onionsat-pcbs/gaia-camera/cansat-camera-pcb/3dmodels/F33Z-1A7Q1-E8C24.stp

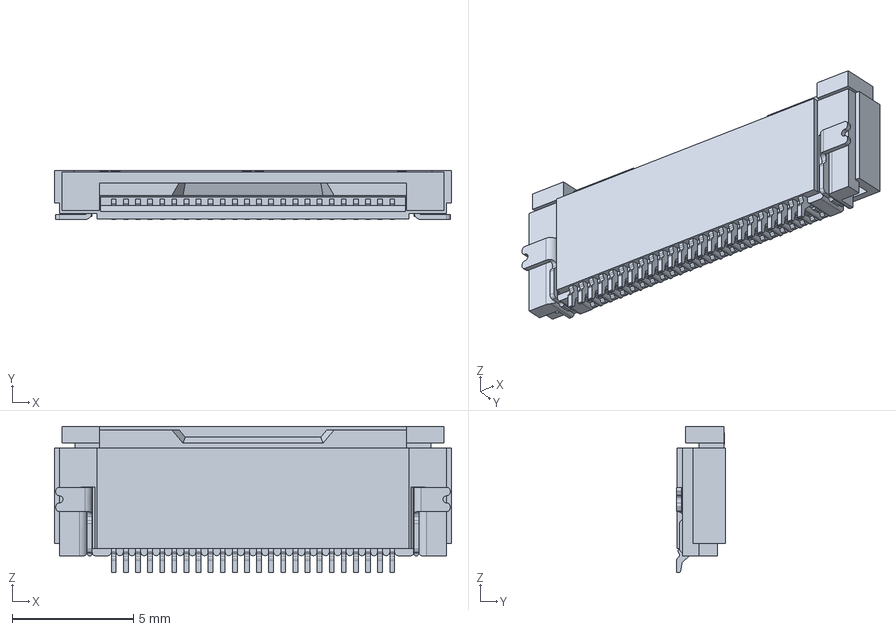
[picture p1: CAD file, 2026-01-25]
cansat-camera-pcb/3dmodels/F33Z-1A7Q1-E8C24.stp
16.4 x 2.03 x 6.05 mm
