onionsat-pcbs/gaia-camera/cansat-camera-pcb/3dmodels/HDR-SMD_8P-P2.00-H-F-W9.2.step

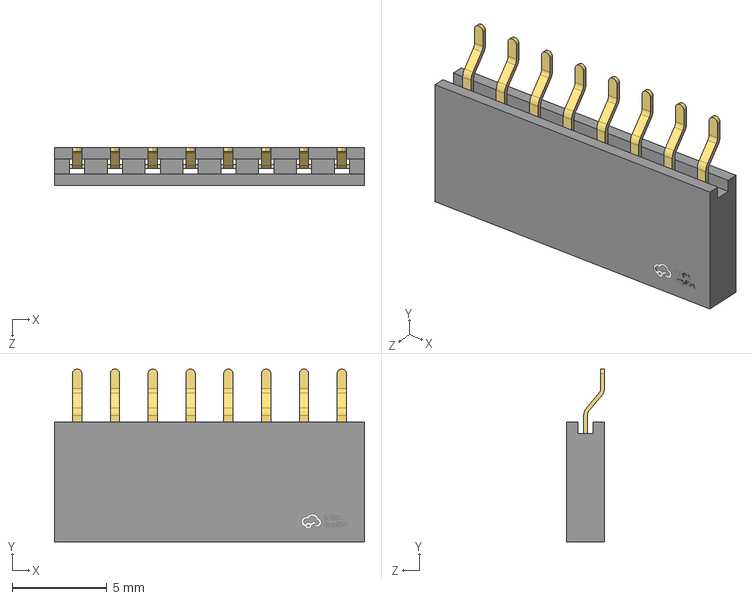
[picture p2: CAD file, 2026-01-25]
cansat-camera-pcb/3dmodels/HDR-SMD_8P-P2.00-H-F-W9.2.step
16.4 x 9.15 x 2.01 mm
