onionsat-pcbs/gaia-camera/cansat-camera-pcb/3dmodels/HDR2.00-F-LS-2X10P.step

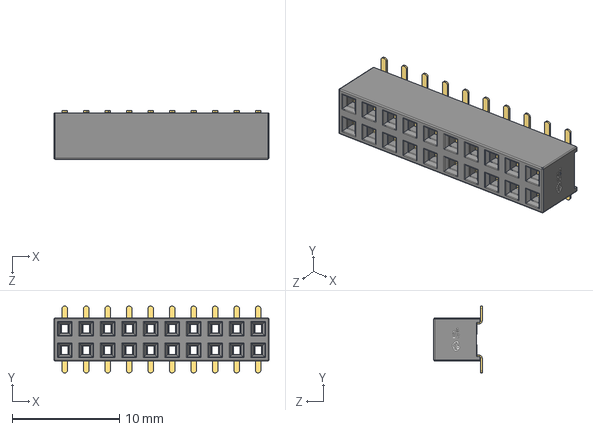
[picture p3: CAD file, 2026-01-07]
cansat-camera-pcb/3dmodels/HDR2.00-F-LS-2X10P.step
20.0 x 6.20 x 4.52 mm
