onionsat-pcbs/gaia-camera/cansat-camera-pcb/3dmodels/OV5640.step

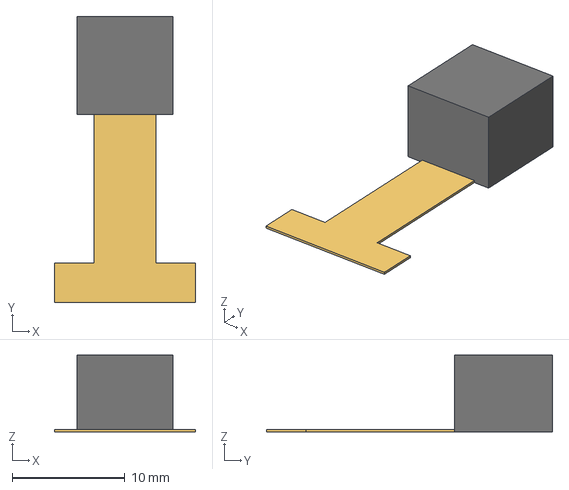
[picture p4: CAD file, 2026-01-03]
cansat-camera-pcb/3dmodels/OV5640.step
12.5 x 25.4 x 6.81 mm
