onionsat-pcbs/gaia-camera/cansat-camera-pcb/3dmodels/KEY-SMD_L4.0-W3.0-LS4.9.step

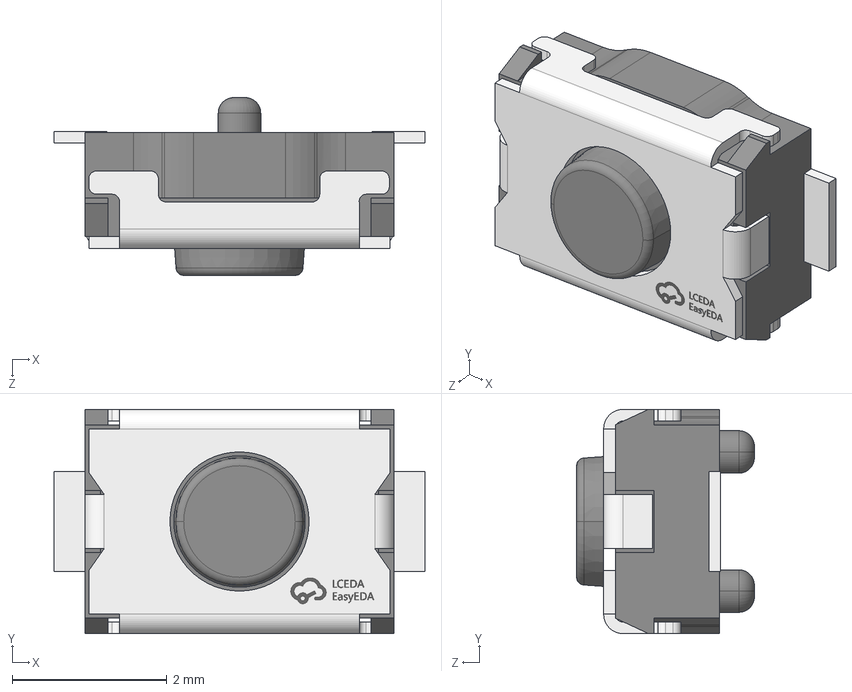
[picture p5: CAD file, 2026-01-03]
cansat-camera-pcb/3dmodels/KEY-SMD_L4.0-W3.0-LS4.9.step
4.80 x 2.90 x 2.30 mm
