onionsat-pcbs/gaia-camera/cansat-camera-pcb/cansat-camera-pcb.kicad_pcb

## KiCad design cansat-camera-pcb/cansat-camera-pcb.kicad_pcb (2026-03-02)

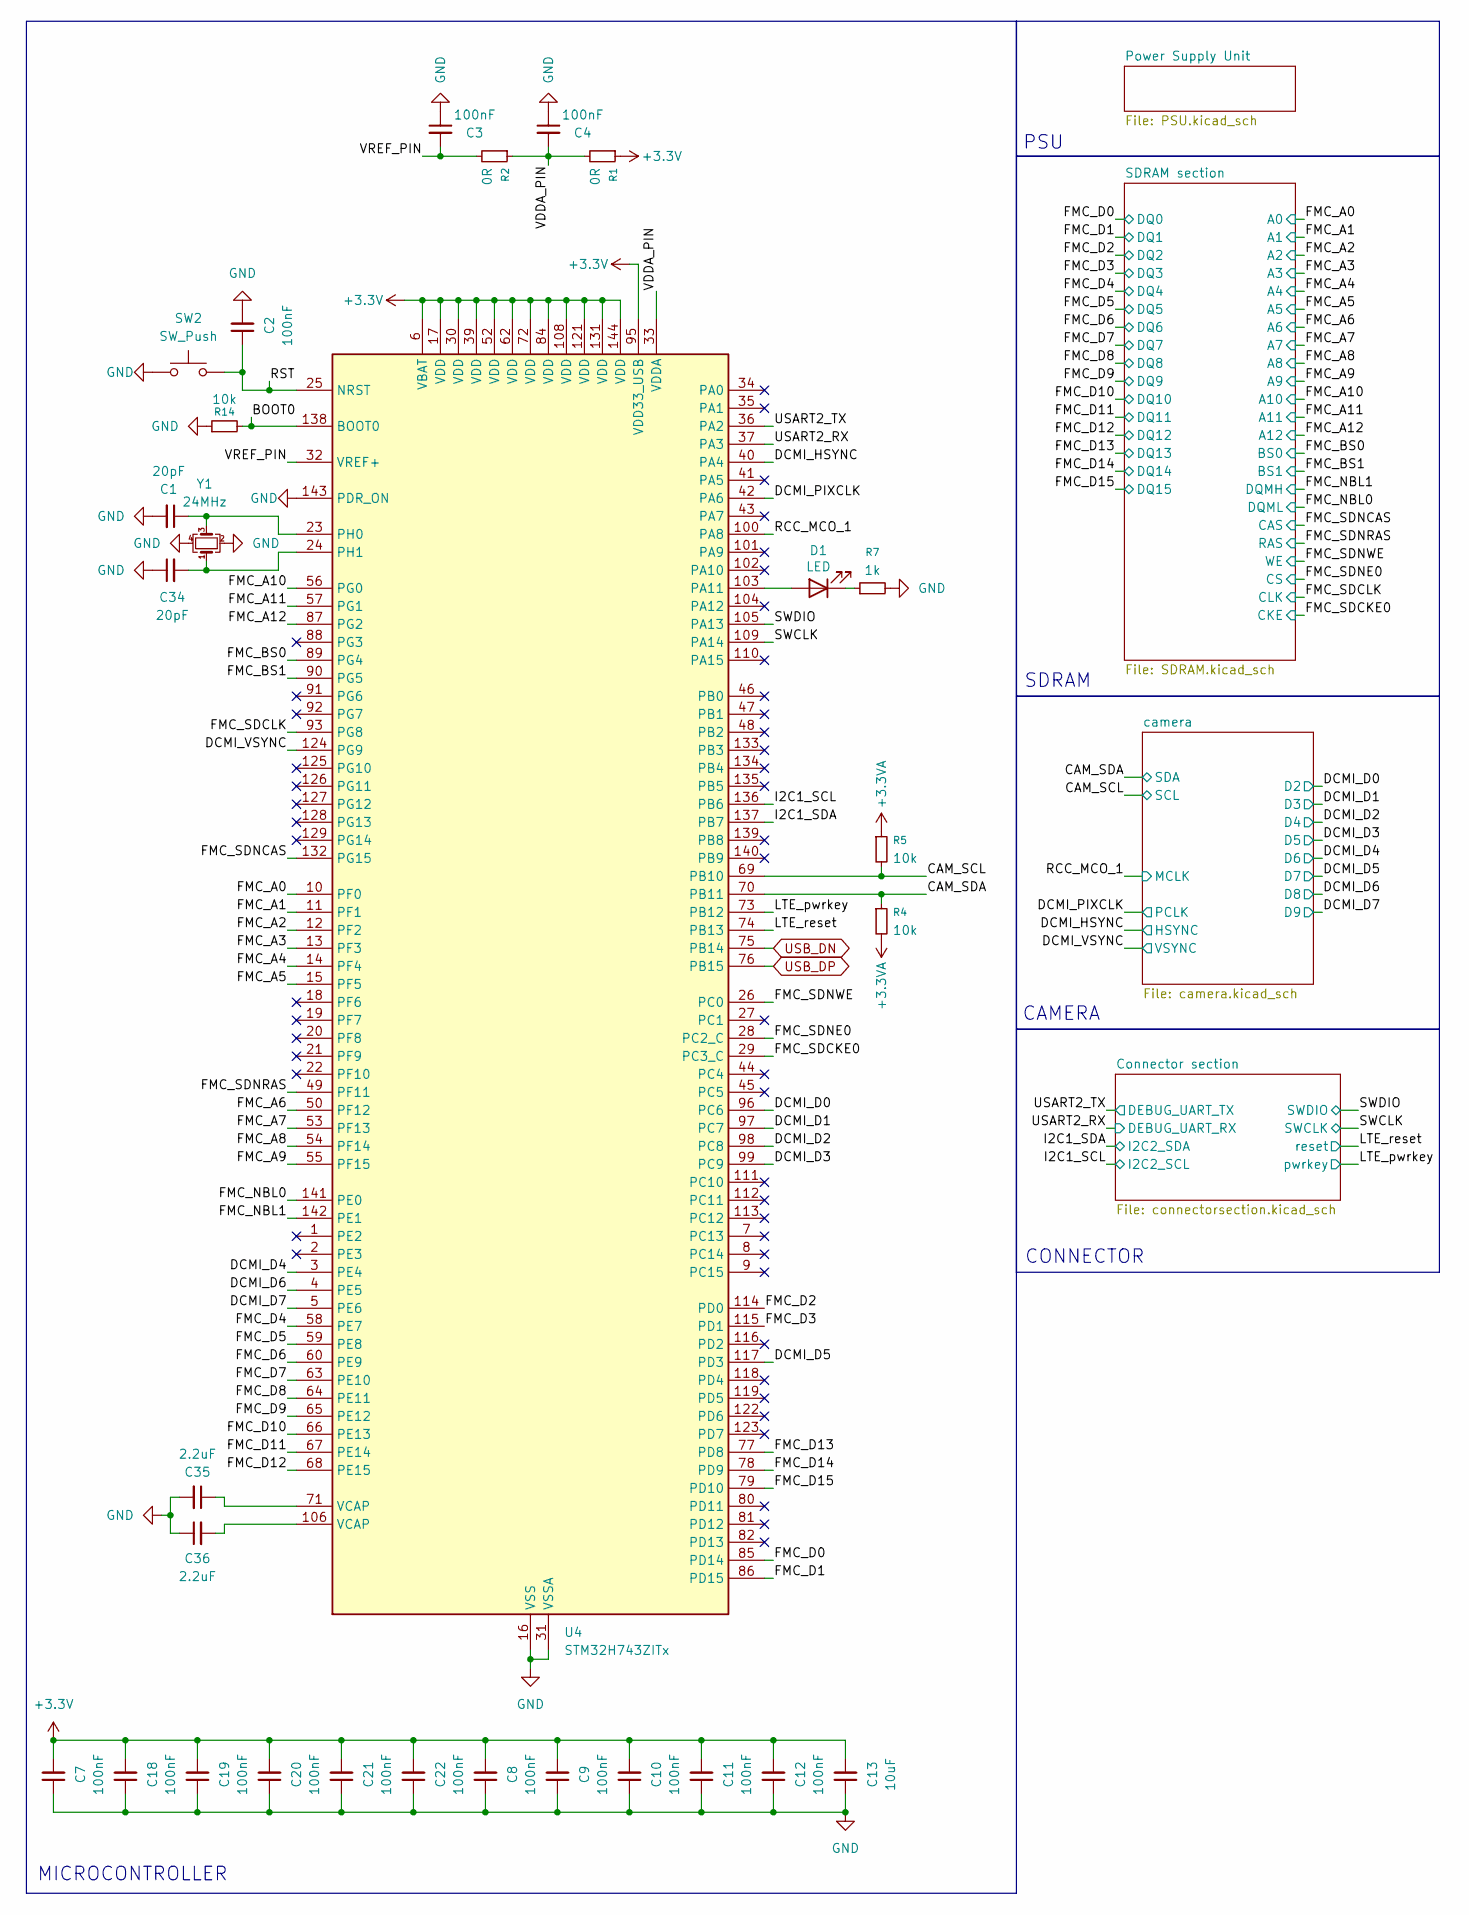
[picture p6: schematic cansat-camera-pcb.kicad_sch, CS26 Camera modul root]

Parts:
C1, C34: 20pF; C_0402_1005Metric
C2, C3, C4, C7, C8, C9, C10, C11, C12, C18, C19, C20, C21, C22: 100nF; C_0402_1005Metric
C13: 10uF; C_0603_1608Metric
C35, C36: 2.2uF; C_0603_1608Metric
D1: LED; LED_0603_1608Metric
R1, R2: 0R; R_0402_1005Metric
R4, R5, R14: 10k; R_0402_1005Metric
R7: 1k; R_0603_1608Metric
SW2: SW_Push; KEY-SMD_L4.0-W3.0-LS4.9-1
U4: STM32H743ZITx; LQFP-144_20x20mm_P0.5mm
Y1: 24MHz; Crystal_SMD_3225-4Pin_3.2x2.5mm

Connections:
+3.3V: C7.2, C8.2, C9.2, C10.2, C11.2, C12.2, C13.2, C18.2, C19.2, C20.2, C21.2, C22.2, R1.1, U4.6 (VBAT), U4.17 (VDD), U4.30 (VDD), U4.39 (VDD), U4.52 (VDD), U4.62 (VDD), U4.72 (VDD), U4.84 (VDD), U4.95 (VDD33_USB), U4.108 (VDD), U4.121 (VDD), U4.131 (VDD), U4.144 (VDD); also elsewhere on the board
+3.3VA: R4.2, R5.1; also elsewhere on the board
/BOOT0: R14.2, U4.138 (BOOT0)
/CAM_SCL: R5.2, U4.69 (PB10); also elsewhere on the board
/CAM_SDA: R4.1, U4.70 (PB11); also elsewhere on the board
/DCMI_D0: U4.96 (PC6); also elsewhere on the board
/DCMI_D1: U4.97 (PC7); also elsewhere on the board
/DCMI_D2: U4.98 (PC8); also elsewhere on the board
/DCMI_D3: U4.99 (PC9); also elsewhere on the board
/DCMI_D4: U4.3 (PE4); also elsewhere on the board
/DCMI_D5: U4.117 (PD3); also elsewhere on the board
/DCMI_D6: U4.4 (PE5); also elsewhere on the board
/DCMI_D7: U4.5 (PE6); also elsewhere on the board
/DCMI_HSYNC: U4.40 (PA4); also elsewhere on the board
/DCMI_PIXCLK: U4.42 (PA6); also elsewhere on the board
/DCMI_VSYNC: U4.124 (PG9); also elsewhere on the board
/FMC_A0: U4.10 (PF0); also elsewhere on the board
/FMC_A1: U4.11 (PF1); also elsewhere on the board
/FMC_A2: U4.12 (PF2); also elsewhere on the board
/FMC_A3: U4.13 (PF3); also elsewhere on the board
/FMC_A4: U4.14 (PF4); also elsewhere on the board
/FMC_A5: U4.15 (PF5); also elsewhere on the board
/FMC_A6: U4.50 (PF12); also elsewhere on the board
/FMC_A7: U4.53 (PF13); also elsewhere on the board
/FMC_A8: U4.54 (PF14); also elsewhere on the board
/FMC_A9: U4.55 (PF15); also elsewhere on the board
/FMC_A10: U4.56 (PG0); also elsewhere on the board
/FMC_A11: U4.57 (PG1); also elsewhere on the board
/FMC_A12: U4.87 (PG2); also elsewhere on the board
/FMC_BS0: U4.89 (PG4); also elsewhere on the board
/FMC_BS1: U4.90 (PG5); also elsewhere on the board
/FMC_D0: U4.85 (PD14); also elsewhere on the board
/FMC_D1: U4.86 (PD15); also elsewhere on the board
/FMC_D2: U4.114 (PD0); also elsewhere on the board
/FMC_D3: U4.115 (PD1); also elsewhere on the board
/FMC_D4: U4.58 (PE7); also elsewhere on the board
/FMC_D5: U4.59 (PE8); also elsewhere on the board
/FMC_D6: U4.60 (PE9); also elsewhere on the board
/FMC_D7: U4.63 (PE10); also elsewhere on the board
/FMC_D8: U4.64 (PE11); also elsewhere on the board
/FMC_D9: U4.65 (PE12); also elsewhere on the board
/FMC_D10: U4.66 (PE13); also elsewhere on the board
/FMC_D11: U4.67 (PE14); also elsewhere on the board
/FMC_D12: U4.68 (PE15); also elsewhere on the board
/FMC_D13: U4.77 (PD8); also elsewhere on the board
/FMC_D14: U4.78 (PD9); also elsewhere on the board
/FMC_D15: U4.79 (PD10); also elsewhere on the board
/FMC_NBL0: U4.141 (PE0); also elsewhere on the board
/FMC_NBL1: U4.142 (PE1); also elsewhere on the board
/FMC_SDCKE0: U4.29 (PC3_C); also elsewhere on the board
/FMC_SDCLK: U4.93 (PG8); also elsewhere on the board
/FMC_SDNCAS: U4.132 (PG15); also elsewhere on the board
/FMC_SDNE0: U4.28 (PC2_C); also elsewhere on the board
/FMC_SDNRAS: U4.49 (PF11); also elsewhere on the board
/FMC_SDNWE: U4.26 (PC0); also elsewhere on the board
/I2C1_SCL: U4.136 (PB6); also elsewhere on the board
/I2C1_SDA: U4.137 (PB7); also elsewhere on the board
/LTE_pwrkey: U4.73 (PB12); also elsewhere on the board
/LTE_reset: U4.74 (PB13); also elsewhere on the board
/RCC_MCO_1: U4.100 (PA8); also elsewhere on the board
/RST: C2.1, SW2.2, U4.25 (NRST)
/SWCLK: U4.109 (PA14); also elsewhere on the board
/SWDIO: U4.105 (PA13); also elsewhere on the board
/USART2_RX: U4.37 (PA3); also elsewhere on the board
/USART2_TX: U4.36 (PA2); also elsewhere on the board
/VDDA_PIN: C4.2, R1.2, R2.1, U4.33 (VDDA)
/VREF_PIN: C3.2, R2.2, U4.32 (VREF+)
GND: C1.2, C2.2, C3.1, C4.1, C7.1, C8.1, C9.1, C10.1, C11.1, C12.1, C13.1, C18.1, C19.1, C20.1, C21.1, C22.1, C34.1, C35.2, C36.1, R7.2, R14.1, SW2.1, U4.16 (VSS), U4.31 (VSSA), U4.38 (VSS), U4.51 (VSS), U4.61 (VSS), U4.83 (VSS), U4.94 (VSS), U4.107 (VSS), U4.120 (VSS), U4.130 (VSS), U4.143 (PDR_ON), Y1.2, Y1.4; also elsewhere on the board
unnamed: C35.1, U4.71 (VCAP)
unnamed: C36.2, U4.106 (VCAP)
unnamed: D1.2 (A), U4.103 (PA11)
unnamed: D1.1 (K), R7.1
unnamed: C1.1, U4.23 (PH0), Y1.3
unnamed: C34.2, U4.24 (PH1), Y1.1
USB_DN: U4.75 (PB14); also elsewhere on the board
USB_DP: U4.76 (PB15); also elsewhere on the board

Notes on the sheet:
PSU
SDRAM
MICROCONTROLLER
CAMERA
CONNECTOR

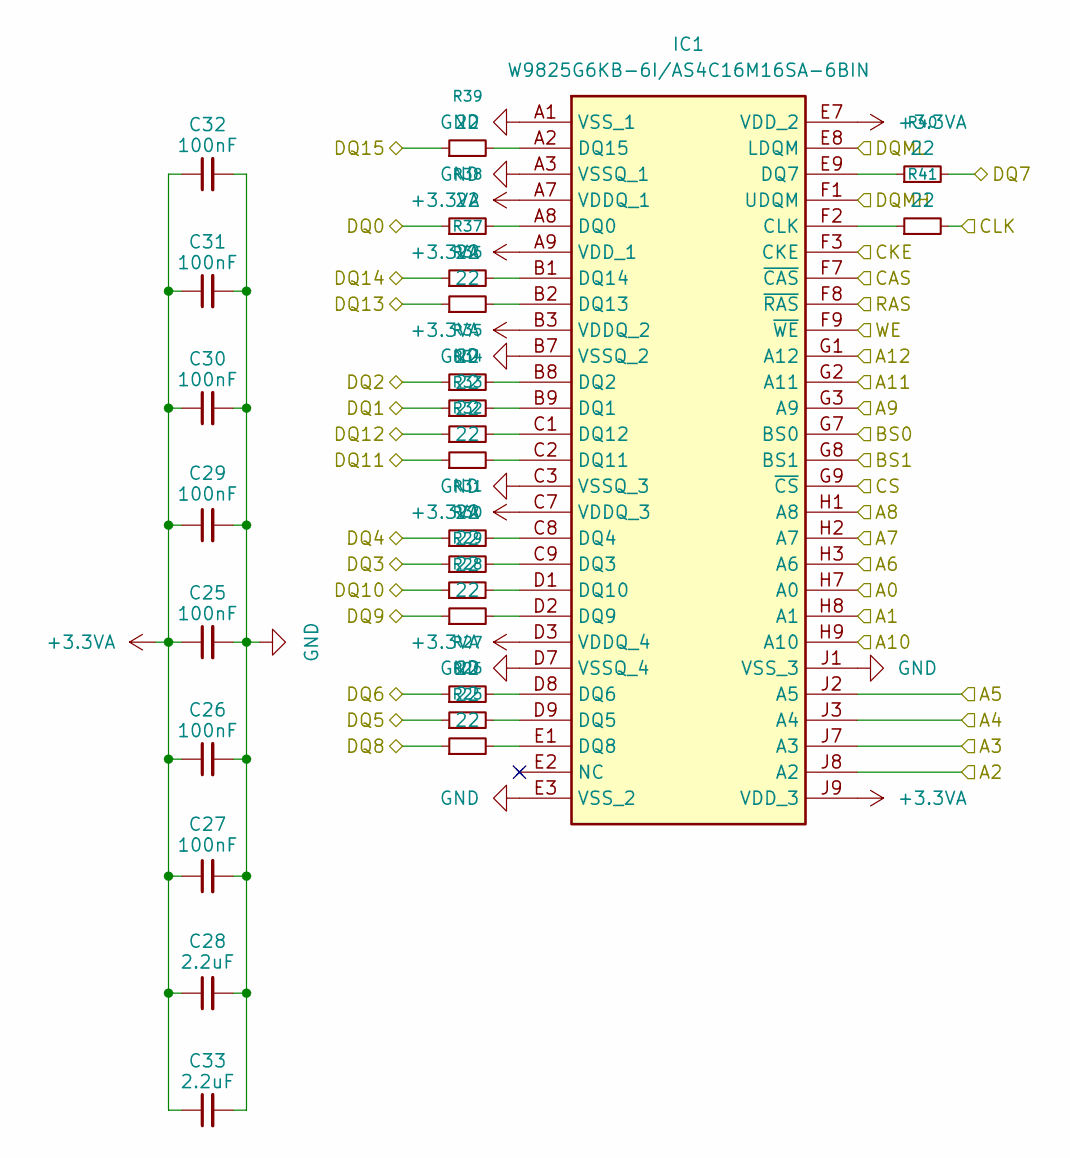
[picture p7: schematic SDRAM.kicad_sch, CS26 Camera modul SDRAM section]

Parts:
C25, C26, C27, C29, C30, C31, C32: 100nF; C_0402_1005Metric
C28, C33: 2.2uF; C_0603_1608Metric
IC1: W9825G6KB-6I/AS4C16M16SA-6BIN; Alliance_TFBGA-54_8x8mm_Layout9x9_P0.8mm; Mouser Part Number 454-W9825G6JB-6I
R25, R26, R27, R28, R29, R30, R31, R32, R33, R34, R35, R36, R37, R38, R39, R40, R41: 22; R_0201_0603Metric

Connections:
+3.3VA: C25.1, C26.1, C27.1, C28.1, C29.1, C30.1, C31.1, C32.1, C33.1, IC1.A7 (VDDQ_1), IC1.A9 (VDD_1), IC1.B3 (VDDQ_2), IC1.C7 (VDDQ_3), IC1.D3 (VDDQ_4), IC1.E7 (VDD_2), IC1.J9 (VDD_3); also elsewhere on the board
/FMC_A0: IC1.H7 (A0); also elsewhere on the board
/FMC_A1: IC1.H8 (A1); also elsewhere on the board
/FMC_A2: IC1.J8 (A2); also elsewhere on the board
/FMC_A3: IC1.J7 (A3); also elsewhere on the board
/FMC_A4: IC1.J3 (A4); also elsewhere on the board
/FMC_A5: IC1.J2 (A5); also elsewhere on the board
/FMC_A6: IC1.H3 (A6); also elsewhere on the board
/FMC_A7: IC1.H2 (A7); also elsewhere on the board
/FMC_A8: IC1.H1 (A8); also elsewhere on the board
/FMC_A9: IC1.G3 (A9); also elsewhere on the board
/FMC_A10: IC1.H9 (A10); also elsewhere on the board
/FMC_A11: IC1.G2 (A11); also elsewhere on the board
/FMC_A12: IC1.G1 (A12); also elsewhere on the board
/FMC_BS0: IC1.G7 (BS0); also elsewhere on the board
/FMC_BS1: IC1.G8 (BS1); also elsewhere on the board
/FMC_D0: R38.1; also elsewhere on the board
/FMC_D1: R34.1; also elsewhere on the board
/FMC_D2: R35.1; also elsewhere on the board
/FMC_D3: R30.1; also elsewhere on the board
/FMC_D4: R31.1; also elsewhere on the board
/FMC_D5: R26.1; also elsewhere on the board
/FMC_D6: R27.1; also elsewhere on the board
/FMC_D7: R40.2; also elsewhere on the board
/FMC_D8: R25.1; also elsewhere on the board
/FMC_D9: R28.1; also elsewhere on the board
/FMC_D10: R29.1; also elsewhere on the board
/FMC_D11: R32.1; also elsewhere on the board
/FMC_D12: R33.1; also elsewhere on the board
/FMC_D13: R36.1; also elsewhere on the board
/FMC_D14: R37.1; also elsewhere on the board
/FMC_D15: R39.1; also elsewhere on the board
/FMC_NBL0: IC1.E8 (LDQM); also elsewhere on the board
/FMC_NBL1: IC1.F1 (UDQM); also elsewhere on the board
/FMC_SDCKE0: IC1.F3 (CKE); also elsewhere on the board
/FMC_SDCLK: R41.2; also elsewhere on the board
/FMC_SDNCAS: IC1.F7 (~CAS); also elsewhere on the board
/FMC_SDNE0: IC1.G9 (~CS); also elsewhere on the board
/FMC_SDNRAS: IC1.F8 (~RAS); also elsewhere on the board
/FMC_SDNWE: IC1.F9 (~WE); also elsewhere on the board
GND: C25.2, C26.2, C27.2, C28.2, C29.2, C30.2, C31.2, C32.2, C33.2, IC1.A1 (VSS_1), IC1.A3 (VSSQ_1), IC1.B7 (VSSQ_2), IC1.C3 (VSSQ_3), IC1.D7 (VSSQ_4), IC1.E3 (VSS_2), IC1.J1 (VSS_3); also elsewhere on the board
unnamed: IC1.F2 (CLK), R41.1
unnamed: IC1.A8 (DQ0), R38.2
unnamed: IC1.B9 (DQ1), R34.2
unnamed: IC1.B8 (DQ2), R35.2
unnamed: IC1.C9 (DQ3), R30.2
unnamed: IC1.C8 (DQ4), R31.2
unnamed: IC1.D9 (DQ5), R26.2
unnamed: IC1.D8 (DQ6), R27.2
unnamed: IC1.E9 (DQ7), R40.1
unnamed: IC1.E1 (DQ8), R25.2
unnamed: IC1.D2 (DQ9), R28.2
unnamed: IC1.D1 (DQ10), R29.2
unnamed: IC1.C2 (DQ11), R32.2
unnamed: IC1.C1 (DQ12), R33.2
unnamed: IC1.B2 (DQ13), R36.2
unnamed: IC1.B1 (DQ14), R37.2
unnamed: IC1.A2 (DQ15), R39.2

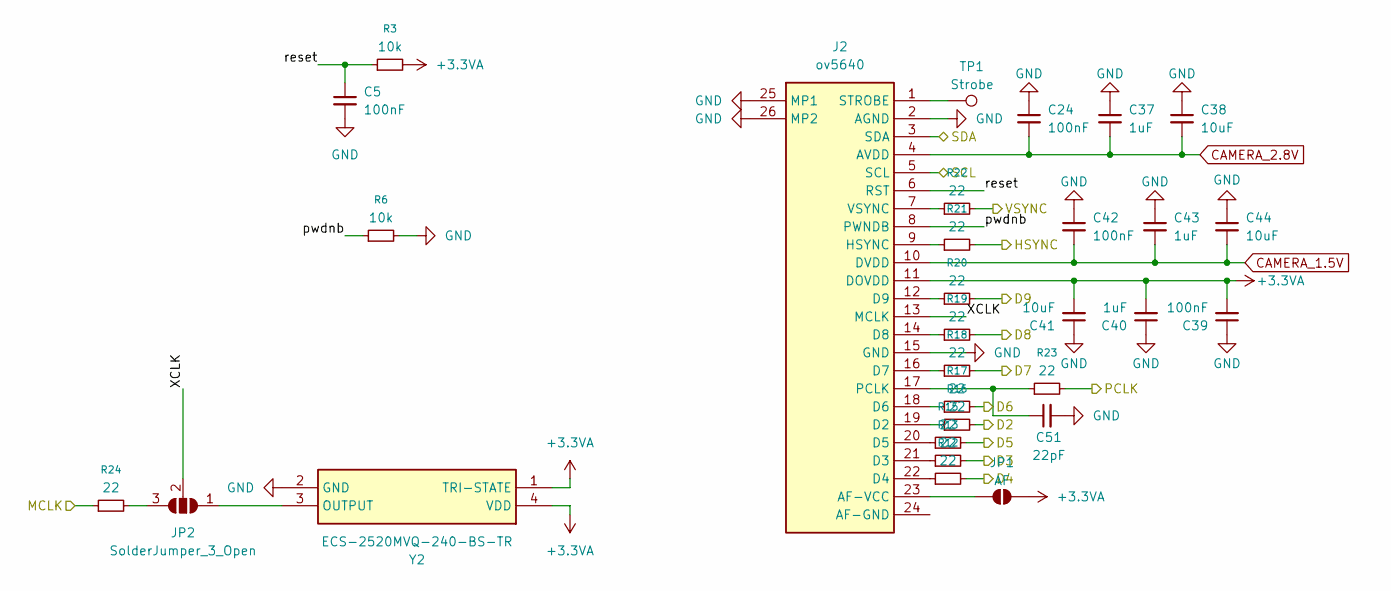
[picture p8: schematic camera.kicad_sch, CS26 Camera modul camera section]

Parts:
C5, C24, C39, C42: 100nF; C_0402_1005Metric
C37, C40, C43: 1uF; C_0603_1608Metric
C38, C41, C44: 10uF; C_0603_1608Metric
C51: 22pF; C_0402_1005Metric
J2: ov5640; F33Z1A7Q1E8C24; Manufacturer_Part_Number F33Z-1A7Q1-E8C24
JP1: AF; SolderJumper-2_P1.3mm_Open_Pad1.0x1.5mm
JP2: SolderJumper_3_Open; SolderJumper-3_P1.3mm_Open_Pad1.0x1.5mm
R3, R6: 10k; R_0402_1005Metric
R12, R13, R15, R16, R17, R18, R19, R20, R21, R22, R23, R24: 22; R_0201_0603Metric
TP1: Strobe; TestPoint_Pad_1.5x1.5mm
Y2: ECS-2520MVQ-240-BS-TR; ECS2520MVQ240BSTR; Mouser Part Number 520-E2520MVQ240BSTR

Connections:
+3.3VA: C39.2, C40.2, C41.2, J2.11 (DOVDD), JP1.2 (B), R3.2, Y2.1 (TRI-STATE), Y2.4 (VDD); also elsewhere on the board
/CAM_SCL: J2.5 (SCL); also elsewhere on the board
/CAM_SDA: J2.3 (SDA); also elsewhere on the board
/DCMI_D0: R16.2; also elsewhere on the board
/DCMI_D1: R13.2; also elsewhere on the board
/DCMI_D2: R12.2; also elsewhere on the board
/DCMI_D3: R15.2; also elsewhere on the board
/DCMI_D4: R17.2; also elsewhere on the board
/DCMI_D5: R18.2; also elsewhere on the board
/DCMI_D6: R19.2; also elsewhere on the board
/DCMI_D7: R20.2; also elsewhere on the board
/DCMI_HSYNC: R21.2; also elsewhere on the board
/DCMI_PIXCLK: R23.2; also elsewhere on the board
/DCMI_VSYNC: R22.2; also elsewhere on the board
/RCC_MCO_1: R24.1; also elsewhere on the board
/camera/XCLK: J2.13 (MCLK), JP2.2 (C)
/camera/pwdnb: J2.8 (PWNDB), R6.1
/camera/reset: C5.1, J2.6 (RST), R3.1
CAMERA_1.5V: C42.2, C43.2, C44.2, J2.10 (DVDD); also elsewhere on the board
CAMERA_2.8V: C24.2, C37.2, C38.2, J2.4 (AVDD); also elsewhere on the board
GND: C5.2, C24.1, C37.1, C38.1, C39.1, C40.1, C41.1, C42.1, C43.1, C44.1, C51.2, J2.2 (AGND), J2.15 (GND), J2.25 (MP1), J2.26 (MP2), R6.2, Y2.2 (GND); also elsewhere on the board
unnamed: J2.23 (AF-VCC), JP1.1 (A)
unnamed: J2.19 (D2), R16.1
unnamed: J2.21 (D3), R13.1
unnamed: J2.22 (D4), R12.1
unnamed: J2.20 (D5), R15.1
unnamed: J2.18 (D6), R17.1
unnamed: J2.16 (D7), R18.1
unnamed: J2.14 (D8), R19.1
unnamed: J2.12 (D9), R20.1
unnamed: J2.9 (HSYNC), R21.1
unnamed: C51.1, J2.17 (PCLK), R23.1
unnamed: J2.1 (STROBE), TP1.1
unnamed: J2.7 (VSYNC), R22.1
unnamed: JP2.1 (A), Y2.3 (OUTPUT)
unnamed: JP2.3 (B), R24.2

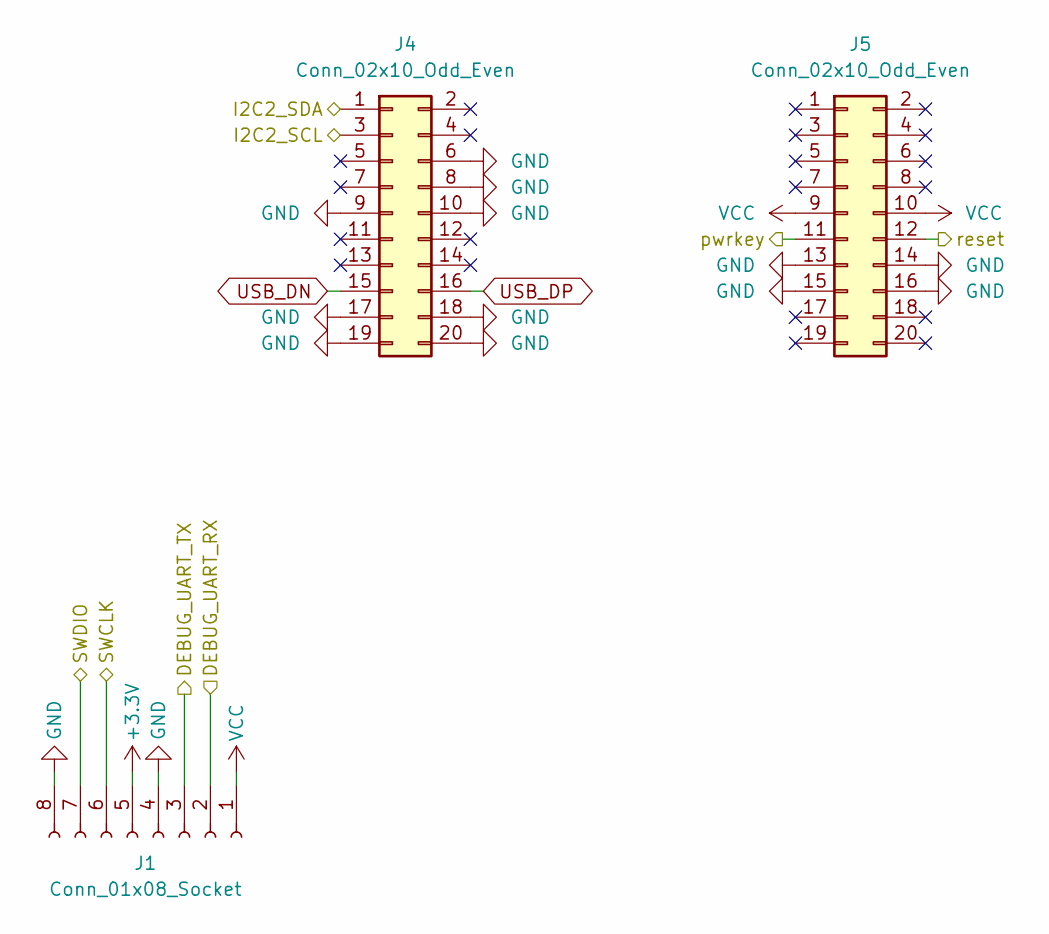
[picture p9: schematic connectorsection.kicad_sch, OnionSAT]

Parts:
J1: Conn_01x08_Socket; HDR-SMD_8P-P2.00-H-F-W9.2
J4, J5: Conn_02x10_Odd_Even; PinHeader_2x10_P2.00mm_Vertical_SMD

Connections:
+3.3V: J1.5; also elsewhere on the board
/I2C1_SCL: J4.3; also elsewhere on the board
/I2C1_SDA: J4.1; also elsewhere on the board
/LTE_pwrkey: J5.11; also elsewhere on the board
/LTE_reset: J5.12; also elsewhere on the board
/SWCLK: J1.6; also elsewhere on the board
/SWDIO: J1.7; also elsewhere on the board
/USART2_RX: J1.2; also elsewhere on the board
/USART2_TX: J1.3; also elsewhere on the board
GND: J1.4, J1.8, J4.6, J4.8, J4.9, J4.10, J4.17, J4.18, J4.19, J4.20, J5.13, J5.14, J5.15, J5.16; also elsewhere on the board
USB_DN: J4.15; also elsewhere on the board
USB_DP: J4.16; also elsewhere on the board
VCC: J1.1, J5.9, J5.10; also elsewhere on the board

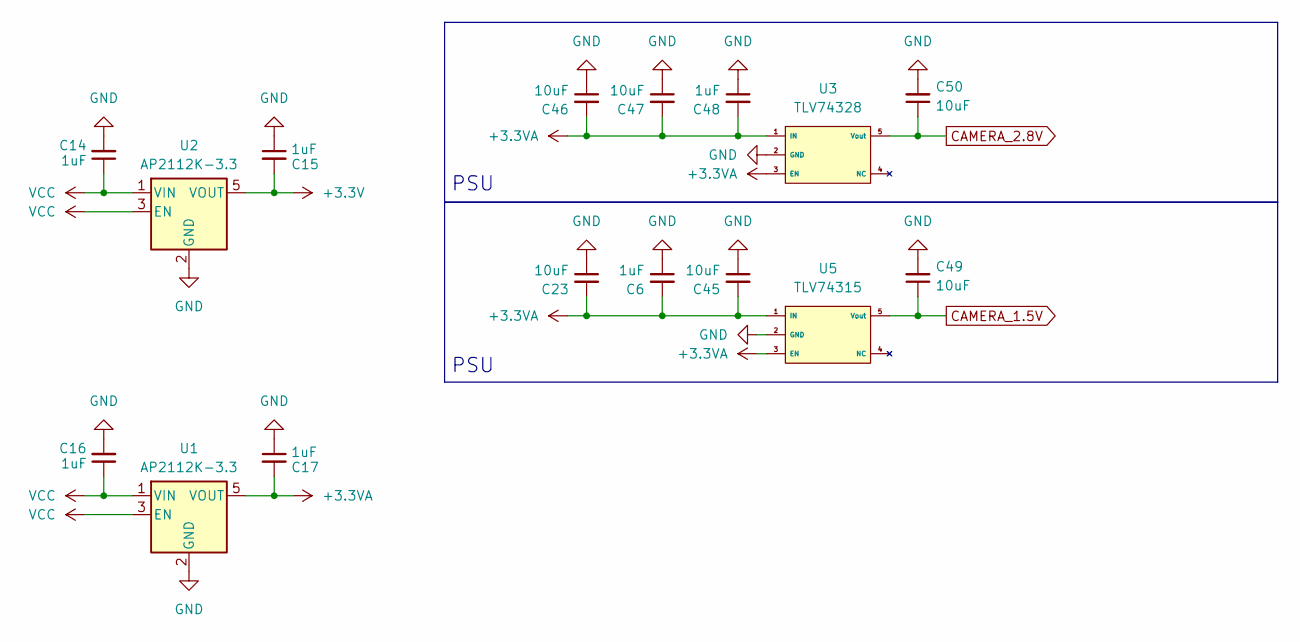
[picture p10: schematic PSU.kicad_sch, CS26 Camera modul PSU section]

Parts:
C6, C14, C15, C16, C17, C48: 1uF; C_0603_1608Metric
C23, C45, C46, C47, C49, C50: 10uF; C_0603_1608Metric
U1, U2: AP2112K-3.3; SOT-23-5
U3: TLV74328; SOT-23-5
U5: TLV74315; SOT-23-5

Connections:
+3.3V: C15.2, U2.5 (VOUT); also elsewhere on the board
+3.3VA: C6.2, C17.2, C23.2, C45.2, C46.2, C47.2, C48.2, U1.5 (VOUT), U3.1 (IN), U3.3 (EN), U5.1 (IN), U5.3 (EN); also elsewhere on the board
CAMERA_1.5V: C49.1, U5.5 (Vout); also elsewhere on the board
CAMERA_2.8V: C50.1, U3.5 (Vout); also elsewhere on the board
GND: C6.1, C14.2, C15.1, C16.2, C17.1, C23.1, C45.1, C46.1, C47.1, C48.1, C49.2, C50.2, U1.2 (GND), U2.2 (GND), U3.2 (GND), U5.2 (GND); also elsewhere on the board
VCC: C14.1, C16.1, U1.1 (VIN), U1.3 (EN), U2.1 (VIN), U2.3 (EN); also elsewhere on the board

Notes on the sheet:
PSU

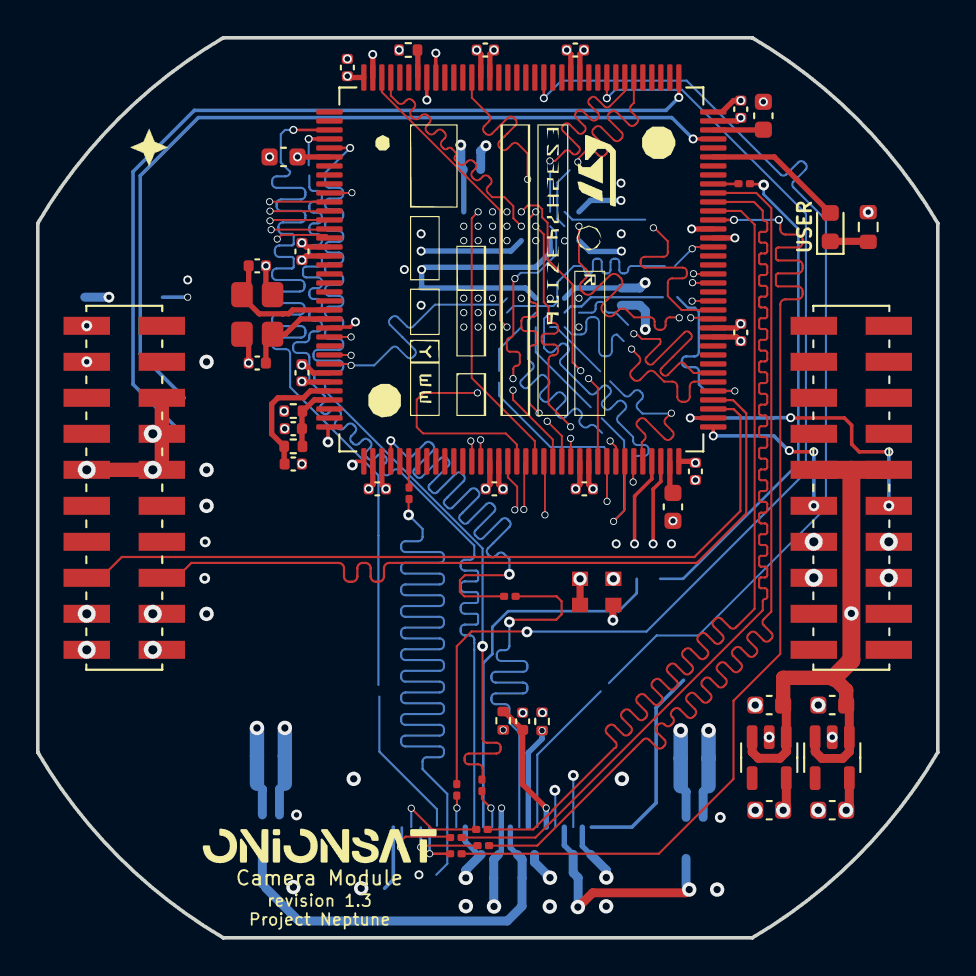
[picture p11: board cansat-camera-pcb.kicad_pcb from above]

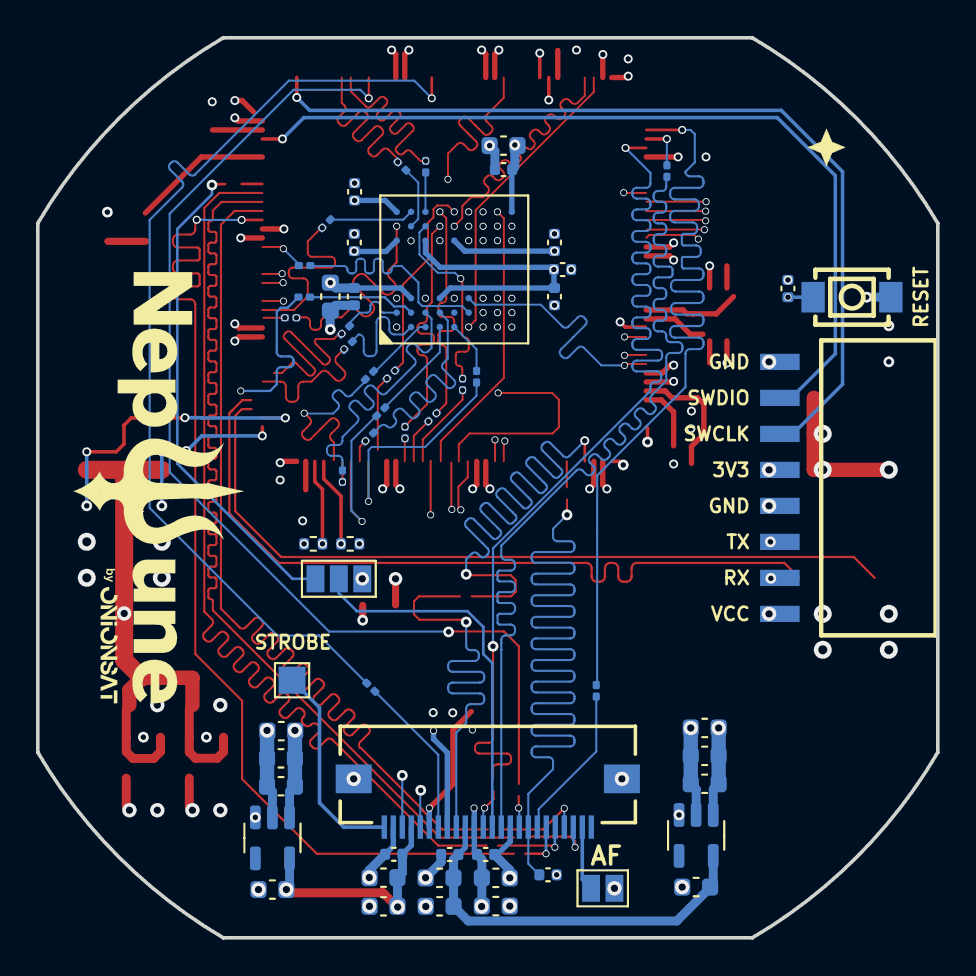
[picture p12: board cansat-camera-pcb.kicad_pcb from below]

Board: 8 copper layers, 50.0 x 50.0 mm, 105 parts (59 on the bottom side), 114 nets.
