onionsat-pcbs/gaia-camera/cansat-camera-pcb/cansat-camera-pcb.ioc

Mcu.UserName=STM32H743ZITx
PA11.Signal=GPIO_Output
PA2.Signal=USART2_TX
PA3.Signal=USART2_RX
PA4.Signal=DCMI_HSYNC
PA6.Signal=DCMI_PIXCLK
PA8.Signal=RCC_MCO_1
PB10.Signal=I2C2_SCL
PB11.Signal=I2C2_SDA
PB12.Signal=GPIO_Output
PB13.Signal=GPIO_Output
PB14.Signal=USB_OTG_HS_DM
PB15.Signal=USB_OTG_HS_DP
PB6.Signal=I2C1_SCL
PB7.Signal=I2C1_SDA
PC0.Signal=FMC_SDNWE
PC2_C.Signal=FMC_SDNE0
PC3_C.Signal=FMC_SDCKE0
PC6.Signal=DCMI_D0
PC7.Signal=DCMI_D1
PC8.Signal=DCMI_D2
PC9.Signal=DCMI_D3
PD0.Signal=FMC_D2_DA2
PD1.Signal=FMC_D3_DA3
PD10.Signal=FMC_D15_DA15
PD14.Signal=FMC_D0_DA0
PD15.Signal=FMC_D1_DA1
PD3.Signal=DCMI_D5
PD8.Signal=FMC_D13_DA13
PD9.Signal=FMC_D14_DA14
PE0.Signal=FMC_NBL0
PE1.Signal=FMC_NBL1
PE10.Signal=FMC_D7_DA7
PE11.Signal=FMC_D8_DA8
PE12.Signal=FMC_D9_DA9
PE13.Signal=FMC_D10_DA10
PE14.Signal=FMC_D11_DA11
PE15.Signal=FMC_D12_DA12
PE4.Signal=DCMI_D4
PE5.Signal=DCMI_D6
PE6.Signal=DCMI_D7
PE7.Signal=FMC_D4_DA4
PE8.Signal=FMC_D5_DA5
PE9.Signal=FMC_D6_DA6
PF0.Signal=FMC_A0
PF1.Signal=FMC_A1
PF11.Signal=FMC_SDNRAS
PF12.Signal=FMC_A6
PF13.Signal=FMC_A7
PF14.Signal=FMC_A8
PF15.Signal=FMC_A9
PF2.Signal=FMC_A2
PF3.Signal=FMC_A3
PF4.Signal=FMC_A4
PF5.Signal=FMC_A5
PG0.Signal=FMC_A10
PG1.Signal=FMC_A11
PG15.Signal=FMC_SDNCAS
PG2.Signal=FMC_A12
PG4.Signal=FMC_A14_BA0
PG5.Signal=FMC_A15_BA1
PG8.Signal=FMC_SDCLK
PG9.Signal=DCMI_VSYNC
