onionsat-pcbs/gaia-camera/(commit log)

2025-08-06 initial relase
    [DTC143ZEBTL.step, LTST-C193TBKT-5A.step, PSU.kicad_sch, SDRAM.kicad_sch, SIM7600E.step, billOfMaterials.xlsx, camera.kicad_sch, cameraPSU.kicad_sch]
2025-08-11 -4g modul(4g modul on other pcb)
    [4g-modul.kicad_sch, DTC143ZEBTL.step, LTST-C193TBKT-5A.step, SDRAM.kicad_sch, SIM7600E.step, billOfMaterials.xlsx, camera.kicad_sch, cameraPSU.kicad_sch]
2025-08-12 Footprint assign
    [4g-modul.kicad_sch, DTC143ZEBTL.step, LTST-C193TBKT-5A.step, SDRAM.kicad_sch, SIM7600E.step, camera.kicad_sch, cameraPSU.kicad_sch, cansat-camera-pcb.kicad_sch]
2025-08-12 Revert "Footprint assign"
    This reverts commit b0d58344ac617605db2b6635d18d5284d5b3f755.
    [4g-modul.kicad_sch, DTC143ZEBTL.step, LTST-C193TBKT-5A.step, SDRAM.kicad_sch, SIM7600E.step, camera.kicad_sch, cameraPSU.kicad_sch, cansat-camera-pcb.kicad_sch]
2025-08-13 Footprint assign
    Reset kivételével minden hozzácsatolva
    [PSU.kicad_sch, SDRAM.kicad_sch, camera.kicad_sch, cansat-camera-pcb.kicad_sch, connectorsection.kicad_sch, sdcard.kicad_sch]
2025-08-13 button footprint added to library and assigned
    [cansat-camera-pcb.kicad_sch]
2025-08-13 Footprint assign final
    [PSU.kicad_sch, SDRAM.kicad_sch, camera.kicad_sch, cansat-camera-pcb.kicad_pcb, cansat-camera-pcb.kicad_sch, sdcard.kicad_sch]
2025-08-14 Alkatrész elhelyezés final
    [camera.kicad_sch, cansat-camera-pcb.kicad_pcb, cansat-camera-pcb.kicad_sch, connectorsection.kicad_sch, sdcard.kicad_sch]
2025-08-17 Sdram finish, stm részben
    [cansat-camera-pcb.kicad_pcb]
2025-08-18 Routing tisztázás (sdram, stm)
    [cansat-camera-pcb.kicad_pcb]
2025-08-19 Stm32, Sdram routolás végleges
    [cansat-camera-pcb.kicad_pcb]
2025-08-21 Routolás folytatása
    [cansat-camera-pcb.kicad_pcb]
2025-08-25 new sdram added, some routing
    sdram added to both footprint library and symbol library
    [W9825G6KH-6.step, cansat-camera-pcb.kicad_pcb]
2025-08-25 Routing+SDram csere
    [SDRAM.kicad_sch, cansat-camera-pcb.kicad_pcb, cansat-camera-pcb.kicad_sch]
2025-08-26 Routolás SDkártya
    [cansat-camera-pcb.kicad_pcb]
2025-08-30 USB fix
    [cansat-camera-pcb.kicad_pcb, cansat-camera-pcb.kicad_sch, connectorsection.kicad_sch]
2025-09-06 Routolás sdram
    [SDRAM.kicad_sch, cansat-camera-pcb.kicad_pcb]
2025-09-08 sdcard deleted form this PCB
    [cansat-camera-pcb.kicad_pcb, cansat-camera-pcb.kicad_sch, connectorsection.kicad_sch, sdcard.kicad_sch]
2025-09-16 Stiching vias
    [cansat-camera-pcb.kicad_pcb]
2025-09-18 adding onionsat to silkscreen
    [cansat-camera-pcb.kicad_pcb]
2025-09-28 Sdram finish, cleanup
    [cansat-camera-pcb.kicad_pcb, cansat-camera-pcb.kicad_sch]
2025-09-28 Cleanup finish
    [cansat-camera-pcb.kicad_pcb]
2025-10-05 some fixes
    [ECS-2520MVQ-240-BS-TR.stp, camera.kicad_sch, cansat-camera-pcb.kicad_pcb, cansat-camera-pcb.kicad_sch, connectorsection.kicad_sch]
2025-10-08 adding heatsink+small fixes
    [camera.kicad_sch, cansat-camera-pcb.kicad_pcb, connectorsection.kicad_sch]
2025-10-08 send to production
    [PSU.kicad_sch, SDRAM.kicad_sch, camera.kicad_sch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]
2026-01-03 3d models
    [ECS-2520MVQ-240-BS-TR.stp, F33Z-1A7Q1-E8C24.STEP, HDR-SMD_5P-P2.54-H-F_X6511FRS-19-C85D30.step, KEY-SMD_L4.0-W3.0-LS4.9.step, OV5640.step, W9825G6KH-6.step, cansat-camera-pcb.kicad_pcb]
2026-01-07 fixing 3d models
    [HDR2.00-F-LS-2X10P.step, cansat-camera-pcb.kicad_pcb]
2026-01-19 dagobert bácsi hegyekben a steksz
    [camera.kicad_sch, cansat-camera-pcb.kicad_pcb, cansat-camera-pcb.kicad_sch, connectorsection.kicad_sch]
2026-01-19 Sdram reroute
    Nem több mint a cím
    [SDRAM.kicad_sch, cansat-camera-pcb.kicad_pcb]
2026-01-20 Sdram route
    sdram reroute
    [cansat-camera-pcb.kicad_pcb]
2026-01-25 milan eszi a havat(unicummal) (jonas is zabalja)
    [ECS-2520MVQ-240-BS-TR.stp, F33Z-1A7Q1-E8C24.STEP, F33Z-1A7Q1-E8C24.stp, HDR-SMD_5P-P2.54-H-F_X6511FRS-19-C85D30.step, HDR-SMD_8P-P2.00-H-F-W9.2.step, PSU.kicad_sch, W9825G6KH-6.step, camera.kicad_sch]
2026-01-25 Finish
    Vége
    [cansat-camera-pcb.kicad_pcb, cansat-camera-pcb.kicad_sch]
2026-01-26 1.1 - production
    [cansat-camera-pcb-B_Cu.gbr, cansat-camera-pcb-B_Mask.gbr, cansat-camera-pcb-B_Paste.gbr, cansat-camera-pcb-B_Silkscreen.gbr, cansat-camera-pcb-Edge_Cuts.gbr, cansat-camera-pcb-F_Cu.gbr, cansat-camera-pcb-F_Mask.gbr, cansat-camera-pcb-F_Paste.gbr]
2026-02-28 Reroute
    Robinak fenomenális buksija van
    [cansat-camera-pcb.kicad_pcb]
2026-02-28 Reroute
    BUksi
    [cansat-camera-pcb.kicad_pcb]
2026-03-01 Fixes SDRAM, routing (1/2)
    [PSU.kicad_sch, SDRAM.kicad_sch, camera.kicad_sch, cansat-camera-pcb.kicad_pcb, cansat-camera-pcb.kicad_sch, connectorsection.kicad_sch]
2026-03-01 CODEGEN + finishing SDRAM routing
    [SDRAM.kicad_sch, cansat-camera-pcb.kicad_pcb]
2026-03-01 OV5640 routing start
    [PSU.kicad_sch, SDRAM.kicad_sch, cansat-camera-pcb.kicad_pcb]
2026-03-01 Finish routing
    [camera.kicad_sch, cansat-camera-pcb.kicad_pcb]
2026-03-01 adding stm orientation mark
    [cansat-camera-pcb.kicad_pcb]
2026-03-01 Fixing routing problems
    [cansat-camera-pcb.kicad_pcb]
2026-03-02 Production v1.3+1.2
    [SDRAM.kicad_sch, camera.kicad_sch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]
